TomasTorrado/Jolteon/web/src/dashboard/assets/eeveelutions.png

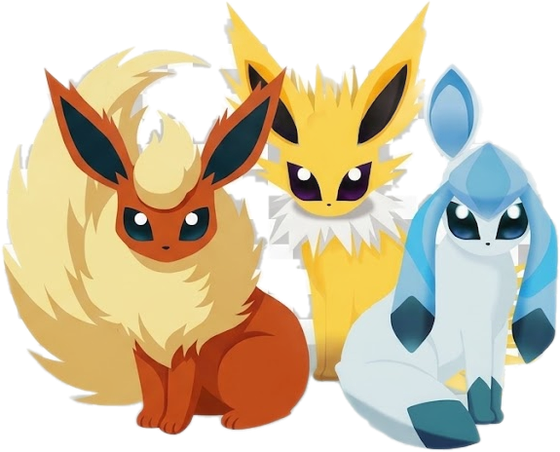
web/src/dashboard/assets/eeveelutions.png
