TomasTorrado/Jolteon/(commit log)

2026-10-10 Test to see battery voltage and discharge
2026-10-10 Add tests for local_db using values from the data contract
    Nine checks against a throwaway test_readings.db:
    - init_db is safe to call twice
    - save_reading stores readings and ignores duplicate seq
    - negative battery current (discharging) is stored as-is
    - missing ts/seq and unknown field names are rejected
    - get_unuploaded returns values in order and respects limit
    - mark_uploaded removes rows from the pending list
    Uses its own database file so the real readings.db is never touched.
2026-10-10 Add bridge that reads and validates ESP32 serial lines
2026-10-10 Insert wiring diagram image in README
2026-10-10 Add ESP32 firmware and make the bridge survive reconnects and reboots
2026-10-10 feat(frontend): add Jolteon monitor dashboard with per-chart time ranges
    Add the React dashboard for the ESP32 thermoelectric generator and wire it
    to the FastAPI endpoints (/api/latest, /api/readings, /api/summary).
    - Three charts in one row: Energy stored, Power, Temperature difference
    - Each chart has its own Live / 12h / 24h tabs and its own hover, so
    changing one doesn't affect the others
    - Live polls every 2s (last 2 min); 12h/24h poll every 10s, downsampled
    with max_points; polling pauses when the tab is hidden
    - Header status shows Live / Can't reach the API / Waiting for first
    reading / No new data
    - Separate "Phone" tab with a charge ring (energy_wh / PHONE_WH)
    - Raw reading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
2026-10-11 Enhance dashboard theming and layout for improved user experience
    - Integrated multiple themes (Jolteon, Flareon, Glaceon, Light) with corresponding surface colors, allowing users to switch themes via a dropdown menu.
    - Updated CSS to ensure consistent styling across themes, including background colors and typography.
    - Improved header layout and responsiveness, ensuring better display on various screen sizes.
    - Fixed visual issues related to dark mode, eliminating unwanted white frames around the UI.
    - Edited assets for better visual fidelity, including adjustments to the eeveelutions image.
    - Enhanced documentation to clarify theme implementation and usage.
2026-10-11 Add wiring diagram to README
